siliconvalley4066/RaspberryPiPicoWOLEDOscilloscope/(threads)

Thread 1 (2025-04-05):

voltage multiplier

failman34, 2025-04-05:
Hi. Great project but is it possible to add voltage multiplier function when divider is used?
