siliconvalley4066/RaspberryPiPicoWOLEDOscilloscope/(commit log)

2023-09-10 fix FFT mode by switch
    [GOscillo.ino]
2023-09-13 replace ESP32 identification
2024-03-09 arduinoFFT 2.0.0
2024-08-14 Update schematics
2026-10-13 trial 2Msps
    overclock ADC
2026-10-15 fix DMA channel leak
2026-10-15 update the schematics
